chriko3/ObscuraOne/(commit log)

2026-04-03 Enhance README with circuit details and diagram
    Added circuit pin mapping and wiring diagram to README.
2026-04-03 Update README with SD Card and assembly instructions
    Added SD Card requirement and updated assembly steps.
2026-04-03 Adjust image widths in sample shots section
    Updated image widths for sample shots in README.
